BadgePiratesLLC/BadgePirates_Common_Library/Displays/README.md

BP Logo
# BadgePirates Common Library #

This repo contains our footprint library, logos, symbols and more

## How to import footprints into KiCad
[from SnapEDA](https://support.snapeda.com/en/articles/2651507-how-to-import-into-kicad)
1. In KiCad, go to Tools > Edit PCB Footprints.
2. Click on Preferences > Manage Footprint Libraries.
3. Click on Browse Libraries and navigate to the Folder of downloaded .kicad_mod file. Then click OK. The library will appear in the Global Libraries tab.

KiCad Browse

BadgePiratesLogos.pretty are also imported as footprints
