BadgePiratesLLC/BadgePirates_Common_Library/(threads)

Thread 5 (2022-10-19):

Create USB Type-C footprint in BadgePiratesLLC/BadgePirates_Common_Library

Reid-n0rc, 2022-10-19:
Created USB type-c footprint identified in BadgePiratesLLC/project-llama/issues/9

Closed 2022-10-26.
