BadgePiratesLLC/BadgePirates_Common_Library/(commit log)

2020-06-27 Create BatteryHolder_LINX_BAT-HLD-012-SMT.kicad_mod
    Added Battery Holder that we have in stock in the thousands! :)
2020-09-25 moved folders
    Moved Footprint folder and added symbol folder, moved footprints to footprint folder
2020-10-09 Update of Footprints
    Added Resister, Cap, button and switch footprints
2021-03-26 added files
    LED and PIN
2021-03-26 added FootPrints
2021-03-28 Updated for kicad 5.99, Added footprints for BSidesKC2021
2021-04-01 Create NG_Logo.kicad_mod
    adding Network Geek Logo FootPrint
2021-05-23 Holes and SAO Holder Back
2021-05-29 adding new footprints
2021-06-18 Create Slot_12mm.kicad_mod
    added a slot hole for Flat Head Lanyard clamp
2021-08-28 adding graphics to footprints
2021-09-27 Update Logo and adding footprints
2021-10-01 esp footprints
2021-12-30 Cleanup
    Cleaning some old footprints and adding new ones
2022-03-12 Footprints add
    adding some footprints
2022-04-27 Update LED_Osram_Lx_P47F_D2mm_ReverseMount_Proper_Mask Only.kicad_mod
2022-06-24 Fixing Battery and LED Logo
2022-09-05 adding footprints
2022-09-13 Update 2032 Through Hold Holder.kicad_mod
2022-09-13 Moving Footprints
    moving project specific footprint to their specific projects
2022-09-25 update footprints
2022-10-01 adding footprints
    MouseBites and 2450 Footprint
2022-10-03 Add PESD2USB3UV-TR
    Added PESD2USB3UV-TR ESD protection diode to the library.
2022-10-03 Update README.md
    Changed "Logos.pretty" on the last line to match the actual footprint library name.
2022-10-14 Create LED_RGB_1210.kicad_mod
    created a 4 pin RGB Reverse Mount Footprint
2022-10-16 Added symbol for IFX27001TFV
    Added modified symbol of IFX27001TFV that includes 4th pin for output to match the actual part and be usable on default KiCad footprint.
2022-10-16 Added additional symbol for IFX27001TFV33 fixed regulator
    Added additional symbol for IFX27001TFV33 fixed regulator with 4th pin to allow for default footprint to be used.
2022-10-26 Create GT-USB-7002C.kicad_mod
    Created footprint for GT-USB-7002C
2022-10-26 Created symbol for USB C Connector
    Created symbol for USB C Connector and linked to BP footprint TYPE-C-31-M-14
2022-11-19 Create a footprint for when Pin 2 and 4 of TO-223 are combined
    Create a footprint for when Pin 2 and 4 of TO-223 have a combined function, such as output.
2022-11-21 Create 2032 Through Hold Holder.kicad_mod
2022-11-23 Footprint Adjustments
2022-12-07 Added Sparkfun KiCad library as a submodule
2023-01-13 Create TPS61040 Symbol
    Create symbol for TPS61040 switching regulator.
2023-01-18 Created TPS63020 and +3V7 Power pin
2023-01-21 Created +2V3 power symbol
2023-01-21 Fixed TPS61023 symbol to match schematic
2023-02-07 Create CD54_IND.kicad_mod
    Created footprint for the XRCD54-1R0M_ inductor
2023-02-07 Stole footprints from Wrickert
2023-05-14 updating Footprints
2023-06-15 new Footprint and Symbol for SP4T
2023-07-10 Fix footprint
    Change footprint to SOT563
2023-07-12 AMAMW footprint
2023-07-13 Better align solder mask.
2023-07-18 Created M24SR02-Y
    Created M24SR02-Y IC RFID Transponder with I2C 8SO
2023-07-18 Updated M23SR02 default footprint
2023-07-18 Removed solder mask from vias
2023-07-18 Update 5.5uH_coil.kicad_mod
    Update 5.5uH_coil to have 6mil lines/spaces
2023-07-25 Created TPS63000DRC
    Created TPS63000DRC buck-boost converter designed to be used with LiPo batteries
2023-07-25 Added TPS61170 Buck,Boost,SEPIC regulator
2023-07-25 Create a net tie symbol and footprint
    Create net tie symbol and footprint for tying different nets, like split grounds, together at a single point.
2023-07-26 Added part info to SAO connector
    Added part numbers, Vendor names and vendor pn, default footprints to the SAO connector symbol
2023-07-26 Update Fab Attr
    Updated fabrication attributes to aid with DRC and BOM generation.
2023-07-31 Added Keebio-parts library
    Added Keebio-parts library as a submodule for the SK6812MINI-e footprint
2023-08-03 Update LED_Osram_Lx_P47F_D2mm_ReverseMount_Proper_Mask Only.kicad_mod
    Added solder mask removal on the Front layer. Defined keep one zone that will include removing copper pours on Front, Back, and Inner layers.
2023-08-03 Update LED_RGB_1210.kicad_mod
    Changed the keep out rule to apply to all layers including inner. Added mask to front.
2023-08-07 Modified rear LED footprints
    Removed the restrictions on the front mask and front keep out rules to allow for custom shapes on the front.
2023-08-22 adding common footprints
2023-08-22 update to Pad Headers .. and 14500 Battery footprings
2023-10-15 fixing some reverse mount settings and makermarks
2023-10-26 Added MAX17048 symbol and footprint
2023-10-30 making some footprints
2023-11-04 Update TF_PUSH.kicad_mod
    Some change didn't get save. Now it is
2023-11-04 Update TF_PUSH.kicad_mod
    Fixed pin numbers
2024-07-21 Update QBLP615.kicad_mod
    Fixed marking
2024-07-24 new footprints
2024-08-12 footprint update
2024-10-05 Create SW_SPST_TL3342 (NewButton).kicad_mod
2026-06-10 Add RFM95W (SX1276) symbol + HOPERF_RFM9XW_SMD footprint
    For the CC15 LoRa satellite. Symbol copied from KiCad 9 stock RF_Module
    lib; Footprint property set to BadgePirates:HOPERF_RFM9XW_SMD (footprint
    added to BadgePiratesFootprint.pretty). Validated with kicad-cli sym upgrade.
2026-06-10 Dedupe footprints: keep BadgePirates copies, drop redundant alternates
    Removed 6 duplicate footprints (kept the design-referenced BadgePirates:
    versions, which are equal-or-better — e.g. only BadgePirates SOT-223 had a
    3D model). Dropped: ESP32-S3-WROOM-1 / ESP32-S2-WROOM / ESP32-S2-WROVER from
    Espressif.pretty; SOT-223 / SOIC-8-1EP_W3.9mm / SOD-123 from
    digikey-footprints.pretty. Submodules (kicad-libraries, SparkFun, Keebio)
    untouched. Reversible via git if any old badge referenced those nicknames.
2026-06-10 Backfill MFG_PN on parts with known part numbers
    Filled MFG/MFG_PN (+LCSC where in Master BOM) for: C_100uf_CASE-B-3528
    (TAJB107M006RNJ / C7195), NE555DR, 74HC4017D-Q100J, 74HC75D,653.
    Validated with kicad-cli sym upgrade. Other blank-MFG_PN parts are either
    not in the Master BOM, part FAMILIES needing an orderable suffix, or
    generics (jumpers/net-ties/SAO connector) with no MPN — left blank rather
    than guess a wrong sourcing number.
2026-06-10 Add stock KiCad 3D models to 5 standard-package footprints
    SOD-123, CAPC3216X135 (1206 cap), RESC3216X70 (1206 res), SOT-223_2-4,
    SOT95P280X145-5N (SOT-23-5) now reference KiCad's stock .step models
    (${KICAD9_3DMODEL_DIR}), with the aligned offset/rotate copied from the
    matching stock footprint. Verify alignment in 3D view. Custom parts
    (buzzer, screen, USB-C, encoder, SD, OLED, etc.) still need sourced STEP files.
2026-06-10 TL3341 + PushPush switch footprints
2026-06-11 Add Johanson 0915AT43A0026 915MHz chip antenna footprint (for CC15 LoRa)
2026-08-22 repo: stop KiCad local state and CRLF churn from dirtying the tree (Nexus edd15f3d)
    Same fix applied to cc15 (cbce6f8). Windows git EOL-converts KiCad files on
    checkout, so they show modified with an empty content diff; combined with
    tracked .kicad_prl / fp-info-cache and a '*-backup/' vs '*-backups/' gitignore
    near-miss, every KiCad open dirtied the tree. The GamingCrap auto-pull task is
    fast-forward-only and refuses on a dirty tree, so the repo silently stopped
    updating. Kevin should type nothing to open a project.
2026-08-23 feat(lora-satellite-v2): add Seeed Wio-SX1262 footprint + symbol (Nexus e2770234)
    Footprint geometry pulled from Seeed's own production KiCad project
    (github.com/Seeed-Studio/OPL_Kicad_Library, Wio-SX1262 for XIAO ESP32S3,
    Module:MODULE12P-1.27-11X11.6MM), re-centered on origin. Matches datasheet
    Figure 9 (Wio-SX1262 Module Datasheet V1.0). 12-pin symbol wired to real
    pinout: RF_SW/MISO/MOSI/SCK/NRST/NSS/GND/VCC on left, ANT/GND/BUSY/DIO1 on
    right, per Figure 2. RF_SW confirmed safe to leave unconnected — Meshtastic's
    shipped variant for this exact module (seeed_xiao_s3/variant.h) uses
    SX126X_DIO2_AS_RF_SWITCH and never drives RF_SW.
2026-08-23 fix(hardware,bucky): Seeed_Wio-SX1262 footprint pad size was transposed, causing adjacent-pad copper overlap
    Pad size was (1.6mm along pitch axis, 0.6mm across) for all 12 gull-wing
    pads at 1.27mm pitch. 1.6mm width at 1.27mm pitch overlaps adjacent pads
    by ~0.33mm of copper -- a dead short between every adjacent signal
    (SCK-NRST, NRST-NSS, NSS-GND, GND-VCC, etc). Confirmed via pcbnew
    GetBoundingBox() on adjacent pads, then reproduced as kicad-cli DRC
    solder_mask_bridge violations on the LoRa v2 satellite layout (Nexus
    e2770234) before this was caught.
    Swapped to (0.6mm across pitch, 1.6mm extending away from the body) --
    standard gull-wing pad proportions for this pitch, matches typical SM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
2026-08-30 feat(bucky): add C_1206_3216Metric footprint, missing 1206 capacitor size
    Library had R_1206_3216Metric and LED_1206 but no capacitor equivalent —
    needed to resize hand-solder-standard passives (Nexus 81b1b9cb) on any
    board using sub-1206 caps. Same pad/courtyard geometry as the existing
    1206 parts in this library for consistency.
    Nexus ab5c2979.
2026-08-30 Add silkscreen pin-1 dot to 25 orientation-sensitive footprints missing one
    Audit for Nexus 32486e5c (Kevin: SAO-NFC v1.0 shipped U1 with no pin-1
    indicator at all, cost an afternoon establishing orientation before the real
    bug could be looked at). ICs, diodes, LEDs, electrolytics, connectors, and
    battery holders across BadgePiratesFootprint.pretty had no silkscreen dot and
    in some cases no courtyard at all. Placed a filled F.SilkS circle at the
    courtyard/body corner nearest pin 1/anode-cathode pad, verified every edited
    footprint still parses and exports via kicad-cli.
    Courtyard notch/chamfer (the second, redundant indicator the standard also
    calls for) is not done here — needs correct-b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
2026-08-30 Un-track VZ43FC1B5640007L-ERM-Motor.kicad_mod — not part of this change
    Swept in by a glob add alongside the pin-1 dot commit; it's someone else's
    in-progress footprint (untracked before my commit). Leaving the file on disk,
    just removing it from git so it doesn't ship under my commit message.
2026-08-30 feat(hardware,bucky): author ESP32-S3-MINI-1 KiCad symbol (Nexus e2770234)
    No native Espressif KiCad symbol exists for the MINI-1 module, and the
    library's existing "ESP32-S3" symbol is the bare QFN-56 chip with the
    wrong pin count/numbering for the module. Authored a new symbol with
    46 unique pin numbers (1-45 signal + shared GND ring pad 46), matching
    the existing Espressif.pretty/ESP32-S3-MINI-1.kicad_mod footprint's 46
    unique pad numbers pad-for-pad.
    Pin names/functions sourced from Espressif's official Table 3-1 Pin
    Definitions (esp32-s3-mini-1_mini-1u_datasheet_en, documentation.espressif.com),
    cross-checked against the Mouser-hosted copy of the same datasheet.
    Key pins for the LoRa-S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
2026-08-31 fix(footprint): add silkscreen pin-1 dot to PinHeader_1x02_P2.54mm_Vertical
    Missed by the 3955a13 audit (Nexus 32486e5c). Filled F.SilkS circle at the
    courtyard corner nearest pad 1, verified via kicad-cli fp export svg (renders
    clean, no pad overlap). Part of closing hw-deliverables pin1-marker-check
    findings (Nexus b8df6668).
2026-09-01 fix(m24sr02): fill blank MPN/Vendor1_PN for M24SR02-Y
    Nexus 0366842c QA flagged M24SR02-Y had a blank MPN despite being on
    the known-blank list. Filled from the exact part handed to dev in the
    ticket: M24SR02-YMN6T/2, DigiKey 497-14353-1-ND. Validated with
    kicad-cli sym upgrade before commit per library's fragile
    textual-property-edit history.
2026-09-01 Add courtyard chamfer notch at pin-1 corner (Nexus b639d863 / 32486e5c)
    Second half of the pin-1 marker standard: 3955a13 added the silkscreen dot
    but deferred the courtyard notch as "needs correct-by-construction polygon
    editing per footprint." Scripted it instead of doing it by hand in the
    KiCad GUI (Jared, fleet review on b639d863, confirmed this is scriptable
    file-editing, not GUI-only work).
    For each footprint from 3955a13 (minus VZ43FC1B5640007L-ERM-Motor, which
    e805fe5 already untracked as out of scope): parsed the F.CrtYd rectangle,
    found the pin-1 dot's nearest corner, and replaced that corner's two
    fp_line segments with a chamfer of min(0.5mm, 25% of the shorter courtyard
    side)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
2026-09-21 fix(3d): repoint 29 stale 3D model paths to KICAD10_3DMODEL_DIR
    Footprints referenced KICAD6/7/8/9_3DMODEL_DIR or KISYS3DMOD, none of
    which resolve on a KiCad 10 install (GAMINGCRAP), plus stale .wrl
    extensions where the upstream model shipped as .step. Filesystem-
    verified each new path resolves against the actual KiCad 10.0.6
    bundled 3dmodels folder before rewriting.
    Nexus 265f2f6a.
2026-09-27 fix(3d-model): point ESP32-S3-WROOM-1 and LED_Osram ReverseMount at portable ${BADGEPIRATES_COMMON_LIB} path
    Both had absolute C:/Users/KevinBennett/OneDrive... paths baked in from the
    original import; the referenced .STEP/.step files are actually present in
    this repo, they were just unresolvable off Kevin's machine. Nexus bb16f69c.
2026-09-27 fix(3d-models): bulk-assign KiCad stock 3D models to generic chip footprints
    0603/0805/1206/1210 in digikey-footprints.pretty were bare 2-pad SMD
    footprints with no model block at all. These are standard imperial chip
    sizes with a 1:1 shape match in KiCad's own shipped library, so point
    them at ${KICAD10_3DMODEL_DIR}/Resistor_SMD.3dshapes/*.step instead of
    sourcing individual STEP files -- cosmetic body shape only, no vendor
    part implied.
    Part of Nexus bb16f69c item 2b (digikey-footprints.pretty bulk pass).
2026-09-27 fix(3d-model): repoint LED_Osram ReverseMount_Proper_Mask sibling to portable path
    Carla's QA on bb16f69c caught this one: same OneDrive absolute-path
    bug as its sibling LED_Osram_..._ReverseMount_WHole (fixed in 0dab6ef)
    but missed in that pass. ReverseMount.step already exists in-repo.
2026-09-27 fix(footprint): close malformed F.CrtYd courtyard on BatteryHolder_MPD_BC2003_1x2032
    Both courtyard arc endpoints were off by ~0.01-0.03mm from the
    adjacent line endpoints, leaving the polygon open and tripping
    KiCad 10's malformed_courtyard DRC on every board using this
    holder (all 4 Celebration 2022 variants). Snapped both arc
    start/end coords to exactly match the neighboring line endpoints
    (-8.94,-5.01 / 8.94,-5.01 / -8.94,5.01 / 8.94,5.01) and centered
    the mid points at (0, +/-10.248).
    Left the _Fixed sibling footprint alone -- it is a different
    variant (different silk text, ref orientation, sheet source),
    not a drop-in replacement, so boards were not swapped to it.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
2026-09-27 fix(3d-models): bulk-assign KiCad stock 3D models to 10 digikey generic packages
    Matched digikey-footprints.pretty entries to identically-dimensioned
    stock KiCad footprints (LGA-24/28, SOD-523, SOIC-18W/24W, SOT-323/353/
    363/563, TO-269AA) by pin count + pad count + package dimension, then
    copied the stock model reference. Verified each resolves against the
    actual KiCad 10 3dmodels dir with ops/kicad_3d_model_check.py's own
    resolver, not by inspection alone.
    Tried SOT-523 too (same pin/pad-count match against KiCad's own stock
    SOT-523.kicad_mod) but KiCad's bundled 3dmodels tree is missing that
    step file too -- reverted, left with no model block rather than a
    second broken reference.
    Nexus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
2026-09-27 fix(3d-models): bulk-assign KiCad stock 3D models to 5 more digikey SOT/SC-70 packages
    Matched digikey-footprints.pretty SOT-23-3/6/8, SOT-23W, and SC-70-5 to
    identically-named stock KiCad footprints by pad count + pad position
    (not name alone -- diffed pad coordinates against the stock
    Package_TO_SOT_SMD.pretty footprints first). Verified each resolves
    using the actual gate script's own resolve_path(), not os.path.exists
    by hand.
    Nexus bb16f69c.
2026-09-27 fix(3d-models): quote+repoint 46 legacy unquoted model paths to resolving KiCad10 stock STEPs
    The gate script's resolve_path() regex requires a quoted (model "...")
    path -- these 46 footprints (mostly Displays/*, plus a handful of
    digikey/BadgePiratesFootprint/Espressif entries) used the pre-KiCad-6
    unquoted legacy syntax (model ${KISYS3DMOD}/... or ${ESPRESSIF_3DMODELS}/...
    with no quotes), so the gate silently miscounted them as "no model" even
    though KiCad itself resolves the bare-token form fine locally when those
    vars happen to be set.
    Repointed each to the equivalent file under KiCad 10's own bundled
    3dmodels tree (same basename, several needed a .wrl->.step swap or a
    different sub-li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
2026-09-28 fix(3d-model): drop unresolvable BATHLD006SMT model block
    The (model ...) block pointed at a literal Windows OneDrive absolute path
    (C:\Users\CrapDesktop\OneDrive - Tier 3 Tech\...\BAT-HLD-006-SMT.stp) that
    never resolves off that one machine, and the referenced .stp isn't in this
    repo at all -- unlike TBU1's tbu-ca.stp, there's nothing to repoint at.
    Dropping the block turns this from a misleading "unresolved" into an
    honest "no model", tracked for real sourcing in the large-effort bucket
    (hardware/audits/3d-audit-unresolved.txt). Nexus bb16f69c Item 1.
2026-09-30 fix(3d-models): add missing model block to SOIC-8-1EP_W3.9mm (CC15)
    Only footprint on the 5 live boards (CC15/LoRa v1/v2/SAO-NFC/BSidesKC27)
    still lacking a model block after prior 9/26-27 bulk fixes. Assigned
    KiCad stock Package_SO.3dshapes/SOIC-8-1EP_3.9x4.9mm_P1.27mm_EP2.41x3.81mm.step,
    verified file exists on host.
    Ref Nexus 5f7525b7.
2026-09-30 fix(3d-models): assign KiCad-stock STEP models to 11 exact-match digikey footprints
    Part of Nexus 5f7525b7 digikey-footprints.pretty bulk-assignment pass.
    Filename-exact matches only (DIP-N_W*mm, SOT-553, TO-18-3, TO-39-3)
    verified against pad count and physical STEP file presence before assignment.
2026-10-01 fix(3d-models): assign KiCad-stock STEP model to SOIC-8_W3.9mm (8-pad exact match)
2026-10-01 fix(3d-models): assign KiCad-stock STEP models to SOD-323/SOD-323F digikey footprints
    Both verified: pad count (2) and dimensions match Diode_SMD.pretty
    D_SOD-323/D_SOD-323F, and both STEP files confirmed present on disk
    (KiCad.app/Contents/SharedSupport/3dmodels/Diode_SMD.3dshapes/).
    SOT-523 was considered but skipped — the stock footprint references
    a STEP file that does not actually exist in the installed library,
    so assigning it would repeat the dangling-model-path bug already
    flagged elsewhere on this ticket.
    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
2026-10-01 fix(3d-models): assign KiCad-stock STEP models to DO-214AC and TO-92-3
    DO-214AC pads (at +-2,0, size 2.5x1.7) match Diode_SMD.pretty D_SMA
    (at +-2,0, size 2.5x1.8) - exact position, industry-standard DO-214AC=SMA.
    TO-92-3 pad positions (0, 1.27, 2.54 in a line, rect+oval+oval) match
    Package_TO_SOT_THT.pretty TO-92_Inline exactly - this is the inline
    variant, not the staggered TO-92.kicad_mod (which has a different
    pad-2 Y offset and would be the wrong body shape).
    DO-214AB and DO-35/DO-41 were checked and skipped: DO-214AB pad spacing
    (+-3.45mm) doesn't match any stock SMB/SMC pitch, and DO-35/DO-41 pad
    pitch (8.56mm/9.2m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
2026-10-01 fix(3d-models): assign stock Package_SO.pretty models to 5 digikey-footprints.pretty SOIC/TSSOP parts
    Verified pad pitch (and pad position in 3 of 5 cases, exact to 4 decimals)
    against stock KiCad footprints before assigning:
    - SOIC-8_W5.3mm -> SOIC-8_5.3x6.2mm_P1.27mm.step (1.27mm pitch match, 5.3mm body matches name)
    - SOIC-16_W3.90mm -> SOIC-16_3.9x9.9mm_P1.27mm.step (pad position exact match, 3.9mm body matches name)
    - TSSOP-8_W4.4mm -> TSSOP-8_4.4x3mm_P0.65mm.step (pad position exact match)
    - TSSOP-20_W4.4mm -> TSSOP-20_4.4x6.5mm_P0.65mm.step (pad position exact match)
    - TSSOP-16-1EP_W4.40mm -> TSSOP-16-1EP_4.4x5mm_P0.65mm.step (0.65mm pitch match, EP package)
    All 5 STEP files confirme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
2026-10-01 feat(3dmodels): assign stock Package_QFP STEP models to 6 digikey TQFP/LQFP footprints
    TQFP-32/48/64_7x7mm and LQFP-32/48_7x7mm, LQFP-64_10x10mm matched to
    stock KiCad Package_QFP.pretty by pin pitch and body size; pad Y-pitch
    exact match, X-extent within rounding of pad-length convention.
    Part of Nexus 5f7525b7-d9de-4e6b-957f-6200b8931c82.
2026-10-01 3D models: assign 6 more digikey-footprints.pretty packages to stock STEP files
    TSSOP-14_W4.4mm -> TSSOP-14_4.4x5mm_P0.65mm.step
    TSSOP-24_W4.40mm -> TSSOP-24_4.4x7.8mm_P0.65mm.step
    TSSOP-28_W4.40mm -> TSSOP-28_4.4x9.7mm_P0.65mm.step
    SOIC-20_W7.5mm -> SOIC-20W_7.5x12.8mm_P1.27mm.step
    SOIC-28_W7.5mm -> SOIC-28W_7.5x17.9mm_P1.27mm.step
    TSSOP-8_W3mm -> TSSOP-8_3x3mm_P0.65mm.step
    Matched by exact pin pitch and pin count, with row separation within
    0.03-0.12mm of the digikey value (consistent with earlier TQFP/LQFP
    findings that digikey pad-length convention differs slightly from
    KiCad's IPC-derived stock footprints). All 6 STEP files confirmed
    present on disk under Package_SO.3dshapes before com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
2026-10-01 3d-models: assign DIP-14_W3mm -> DIP-14_W7.62mm.step
    Row separation (7.62mm) and 14-pin thru-hole pattern match stock
    Package_DIP DIP-14_W7.62mm exactly; digikey's W3mm name refers to a
    different dimension than row spacing. STEP confirmed present on disk.
2026-10-01 fix(3d-models): assign 3 more digikey-footprints.pretty 3D models
    HTQFP-100_14x14mm -> TQFP-100_14x14mm_P0.5mm.step (100 pads, no EP, exact body/pitch match)
    LQFP-100_14x14mm -> LQFP-100_14x14mm_P0.5mm.step (100 pads, no EP, exact body/pitch match)
    LED_0603 -> LED_0603_1608Metric.step (0603/1608 metric LED chip body match)
    Part of Nexus 5f7525b7 3D model library sourcing.
2026-10-01 fix(3d-models): repair 2 broken BadgePiratesFootprint.pretty model paths
    Keystone-1042-0: eec.models/Keystone_-_1042.step (doesn't exist anywhere)
    -> stock Battery.3dshapes/BatteryHolder_Keystone_1042_1x18650.step,
    confirmed by exact Keystone part number match + descr "18650 Plastic
    Battery Holder, Surface Mount".
    SW_Slide_1P2T_CK_TH: stale .wrl path to
    SW_Slide_1P2T_CK_OS102011MS2Q.wrl (KiCad 10 dropped wrl) -> stock
    Button_Switch_THT.3dshapes/SW_Slide_SPDT_Straight_CK_OS102011MS2Q.step,
    confirmed by exact CK Components part number match (OS102011MS2Q is
    the straight variant, not the Angled MA1Q).
2026-10-01 fix(3d-models): assign stock PinHeader 3D models to 7 digikey-footprints.pretty headers
    Pad geometry (straight single/dual row, P2.54mm) matches KiCad stock
    Connector_PinHeader_2.54mm.3dshapes exactly for pin count and orientation;
    minor drill-diameter differences (e.g. 1.02mm vs stock) don't affect the
    3D model since it's render-only, not fab data.
    Nexus 5f7525b7-d9de-4e6b-957f-6200b8931c82
2026-10-01 fix(3d-models): assign stock PinHeader models for 5 more digikey-footprints.pretty headers
    Straight THT single/dual-row headers at P2.54/P2.00/P1.27mm pitch match
    stock Connector_PinHeader_*.3dshapes exactly on pin count and orientation.
    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
2026-10-01 fix(3d-models): assign stock SSOP models for SSOP-16_W3.90mm, SSOP-20_W3.9mm
    Pad pitch (0.635mm) and pin count verified against stock Package_SO.3dshapes
    SSOP-16_3.9x4.9mm_P0.635mm.step and SSOP-20_3.9x8.7mm_P0.635mm.step.
    Nexus 5f7525b7
2026-10-01 3d-model: assign Keystone-54 battery clip STEP
    Verified by pad pattern (3x thru-hole circles at 0,-2.9 / ±5.08,4.72,
    2.78mm pad / 1.83mm drill, courtyard ~19.6x13mm) matching Keystone 54
    spring-clip battery holder for 16-19mm cylindrical cells.
    Nexus 5f7525b7.
2026-10-02 fix(3d-models): assign stock DIP socket models to 12 digikey-footprints.pretty sockets
    Verified pad geometry (pin count, 1.524mm pad / 0.762mm drill, 2.54mm pitch,
    7.62mm or 15.24mm row width) matches stock Package_DIP.pretty *_Socket STEPs
    exactly for each variant.
2026-10-02 fix(3d-models): assign stock D_SMC model to DO-214AB (SMC package)
    Verified pad geometry: A/K smd rect at +-3.45mm, 2.5x3.3mm matches
    stock Diode_SMD D_SMC.step (pad at -3.4mm, 3.3x2.5mm rotated 90).
    DO-214AB is the formal package name for the SMC diode footprint.
    Checked DO-35/DO-35_NK (8.56mm pitch) and DO-41 (9.2mm pitch) against
    stock Diode_THT models -- neither pitch matches any stock variant
    (12.70/2.54mm and 10.16/5.08mm respectively), skipped rather than guess.
    Confirmed DFN-10_2x2mm_P0.4mm / DFN-10_3x3mm / DFN-12-1EP_3x3mm /
    DFN-6_3x3mm_EP1 remain a known blocker: stock Package_DFN_QFN.pretty
    kicad_mod exists but has no corresponding 3dshapes STEP on disk either.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
2026-10-02 3d-models: assign stock TO-220-3/TO-247-3 STEP models
    Verified pad geometry exact match against Package_TO_SOT_THT.pretty
    stock footprints (pad positions 0/2.54/5.08mm and 0/5.45/10.9mm
    respectively). Confirmed target STEP files exist on disk.
2026-10-02 3D models: assign Coax_Conn_U.FL and QFN-48-1EP_7x7mm (digikey-footprints.pretty)
    Coax_Conn_U.FL -> stock Connector_Coaxial/U.FL_Hirose_U.FL-R-SMT-1_Vertical.step,
    rotate z=-90 to align: digikey's ground pads sit at (+/-1.475,0) vs stock's
    (0,+/-1.475), and digikey's signal pad at (0,1.5) vs stock's (-1.525,0) --
    consistent with a 90-degree footprint rotation, confirmed on both pad pairs.
    QFN-48-1EP_7x7mm -> stock Package_DFN_QFN/QFN-48-1EP_7x7mm_P0.5mm_EP5.15x5.15mm.step,
    rotate 0: pin-1 pad position (-3.475,-2.75) and EP size (5.15x5.15) match stock
    exactly, no rotation needed.
    Checked and skipped (EP/pitch matched but rotation unverifiable from pad data
    alone, no stock match at all, or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
2026-10-02 3d-models: assign stock QFP/SOT-23-6 steps (TQFP-44/100x2, SOT23-6L)
    Verified by exact pad-pitch/position match against stock Package_QFP.pretty
    and Package_TO_SOT_SMD.pretty footprints (TQFP-44_10x10mm_P0.8mm,
    TQFP-100_14x14mm_P0.5mm direct; TQFP-100_12x12mm_P0.4mm and SOT23-6L rotated
    -90deg, confirmed by pad-position rotation algebra). Nexus 5f7525b7.
2026-10-02 3d-models: assign stock SSOP-20/28 5.3mm STEPs (rotate 90, verified by pad-rotation algebra)
2026-10-02 3d-models: assign stock PinHeader_1x03_P2.54mm_Vertical step (digikey-footprints.pretty)
    Verified exact pad match (3x thru_hole circle, 2.02mm pad, 1.02mm drill,
    2.54mm pitch) against the stock KiCad PinHeader_1x03_P2.54mm_Vertical
    footprint -- same geometry already confirmed correct for the sibling
    PinHeader_1x2_P2.54mm_Drill1.02mm fix in an earlier session.
2026-10-03 3d-models: assign stock TO-220-11 StaggerOdd STEP (offset verified by kicad-cli render)
    Pad geometry is an exact translated match to Package_TO_SOT_THT.pretty's
    TO-220-11_P3.4x5.08mm_StaggerOdd_Lead4.58mm_Vertical (pitch 1.7mm, stagger
    5.08mm, identical relative-to-pin1 pattern). Digikey's footprint origin is
    centered on the mid pin rather than pin1, so offset (-8.5, 5.08, 0) was
    needed instead of the usual (0,0,0). Verified empirically with
    kicad-cli pcb render (top-orthographic, pixel-measured pad vs lead-tip
    alignment) rather than trusting the algebra alone -- an oblique isometric
    render of the same offset looked misaligned due to perspective, so the
    top-down check was the deciding eviden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
2026-10-03 BadgePiratesFootprint.pretty: assign STEP to CR2032/2032 TH Holder
    LCSC C5239862 (BS-02-A1AJ010, THT 2-pin coin holder) matches both
    duplicate footprints' pad geometry within manufacturing tolerance:
    pitch 20.00mm vs our 19.96mm, drill 1.2mm vs 1.25mm, pad OD 1.8mm vs
    1.7524mm (all deltas <=0.05mm). Pulled via easyeda2kicad, verified
    by kicad-cli pcb render that the model sits correctly over the pads
    before assigning. Rotated 90deg since the source part's pitch runs
    along X and ours runs along Y.
    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
2026-10-03 footprint(TYPE-C-31-M-14): assign STEP model from LCSC C223907 (exact Hroparts part match)
    Pulled via easyeda2kicad, pad geometry/outline matches footprint's own
    descr (Hroparts TYPE-C-31-M-14). Verified by kicad-cli pcb render:
    model loads (0.84s vs ~0.02s empty) and seats correctly over the SMD
    pad row with default offset/rotation, no adjustment needed.
2026-10-03 feat(3d-models): assign STEP for FUET-9032-Buzzer (LCSC C417433)
    Exact part-name match (FUET-9032-3.6V). Pad pitch 8mm matches our
    footprint's 0/8mm pad spacing exactly; body diameter 9.0mm vs our
    silkscreen's 8mm is within cosmetic tolerance for a non-fab-blocking
    model. Verified with kicad-cli pcb render test board before assigning
    (0.39s model-load time, body centered over both pads, + polarity mark
    visible).
    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
2026-10-03 3D models: assign LED_0807, TF_PUSH, CN330N (Nexus 5f7525b7)
    - LED_0807: stock LED_0805_2012Metric.step (pad geom within 0.17mm, cosmetic-only)
    - TF_PUSH: LCSC C393941 SHOU HAN TF-PUSH via easyeda2kicad, exact pad/name match,
    render-verified with offset (0,-6.1,0) correcting origin shift
    - CN330N: stock SOIC-8_3.9x4.9mm_P1.27mm.step rotated 90z (descr says SOIC8,
    pads match pitch/size within tolerance), referenced via KICAD10_3DMODEL_DIR
    (no local copy needed, matches stock-footprint convention)
    All verified via kicad-cli pcb render test boards before assigning.
2026-10-03 feat(3d-models): assign CD54_IND STEP from Sumida CD54 series (LCSC C2826664)
    Pad geometry near-exact match (2.54x5.5mm size, 3.94mm pitch vs reference
    2.5x5.5mm/4.0mm pitch -- 0.06mm delta). Render-verified: drum body
    centered over pads, lead terminations land at pad edges.
    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
2026-10-04 remove stray Footprint Editor.kicad_mod scratch artifact
    Not a real part: reference REF**, value literally 'Footprint Editor',
    no manufacturer geometry. Not referenced by any board pcb/sch in
    agent-repo or this library. Confirmed via git-log/grep evidence per
    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
2026-10-04 feat(3d-models): assign stock PinHeader_2x03_P2.54mm_Vertical STEP to SAOv169 2x3 box headers
    Both footprints' descr explicitly name a through-hole 2x03 2.54mm box
    header. Pad layout is the stock KiCad PinHeader_2x03_P2.54mm_Vertical
    footprint rotated 90deg (3 cols x 2 rows vs stock's 2 cols x 3 rows).
    Render-verified with kicad-cli pcb render before assigning offset.
    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
2026-10-04 feat(3d-models): assign STEP to SSD1306-0.91-OLED-4pin-128x32
    LCSC C5248081 (HS HS91L02W2C01) generated footprint name
    (OLED-TH_L38.0-W12.0) matches our 38x12mm board outline exactly,
    pad pitch 2.54mm/drill 1mm match exactly. Pulled via easyeda2kicad,
    render-verified with kicad-cli pcb render -- pads land centered on
    the connector holes, pin-1 marker visible, board outline matches.
    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
2026-10-04 feat(3d-models): assign GT-USB-7002C STEP (LCSC C5117884, exact name match)
    Nexus 5f7525b7. Pulled via easyeda2kicad (USB-C-SMD_GT-USB-7002C footprint
    name matches our GT-USB-7002C exactly). Pad pitch/drill/shell-tab spread
    confirmed matching ours within tolerance. Offset (0 -2.4 0), no rotation.
    Render-verified by temporarily inserting into a scratch copy of
    Project-Sparky.kicad_pcb (not committed) and rendering with kicad-cli --
    connector body lands centered over all 6 signal pads and 4 shell tabs.
2026-10-04 feat(3d-models): assign C2858290 STEP (exact LCSC part-number match)
    Footprint name is literally the LCSC ID. easyeda2kicad pull of C2858290
    produces SW-SMD-6P-L10.5-W10.0, a 6-pad SMD D-pad switch with 2 mounting
    holes at (+-2.2, 2.2) — exact pad coordinate match to our footprint
    (within 0.05mm on all 6 SMD pads, exact on both mounting holes). No
    offset/rotation needed; coordinate systems align directly. Render-verified
    with kicad-cli pcb render before committing.
2026-10-04 feat(3d-models): assign RESDFN650X400X90-2N STEP (Bourns TBU-CA085-200-WH, LCSC C720643)
    Identified real part via Project-Sparky schematic: this footprint backs
    TBU1, lib_id uctester-eagle-import:TBU-CA, value "TBU-CA". Bourns TBU-CA
    high-speed protectors ship in a DFN2 6.5x4.0x0.9mm SMD-3P package matching
    the footprint descr exactly. easyeda2kicad pull of C720643 produces
    SEMI-SMD_TBU-CA085-200-WH with pads at (-2.02/0/2.02, 0), sizes 2.0x3.6 /
    1.0x3.6 / 2.0x3.6 -- matches our footprint's (-2.025/0/2.025, 0),
    1.9618x3.5118 / 0.8x3.5118 / 1.9618x3.5118 within 0.1mm. No offset/rotation
    needed. Render-verified against Project-Sparky before committing.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
2026-10-04 feat(3d-models): assign STEP to BATHLD006SMT - CR2450 (LCSC C6131016, BAT-HLD-006-SMT exact part match)
    Pad geometry match: two 6x6.2mm rect pads at ±15.3mm + 23mm circle center
    pad, matches generated footprint within 0.2mm. Render-verified against
    Project-Sparky scratch board — holder body with + marking and spring tabs
    lands correctly over the pad footprint.
    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
2026-10-04 feat(3d-models): assign XKB7070-Z-92 STEP (LCSC C318862)
    Exact part-number match named in the footprint's own descr field.
    easyeda2kicad pad geometry (5.0mm col x 2.0mm row, 1.0mm drill) matches
    ours exactly once transposed 90deg. Render-verified against a scratch
    Project-Sparky board before committing.
    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
2026-10-04 feat(3d-models): assign SIQ-02FVS3 encoder STEP (LCSC C2925423)
    Exact Mitsumi part-number match to footprint name. easyeda2kicad pad
    geometry confirms same part (same x-span, same NPTH offset pattern);
    render-verified offset (0 2.65 0) against scratch Project-Sparky board
    -- mounting legs land on the silkscreen box edge correctly.
    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
2026-10-04 fix(gitignore): ignore stray KiCad *-drc.rpt (Nexus f81f825c)
    A manually-exported DRC report from the KiCad GUI sat outside
    _deliverables/ and wasn't gitignored, so it counted as dirty source
    for hw_deliverables_gen.mjs and forced a full regen + Cortex warn
    every 10 minutes.
2026-10-04 fix(espressif): source 9 missing STEP models for ESPRESSIF_3DMODELS gap
    Espressif.pretty footprints referenced ${ESPRESSIF_3DMODELS}/*.STEP but no
    asset ever existed for any of them on this host or in this repo (Nexus
    88670327, LoRa-Satellite-v2 U2 pre-fab gate failure). Downloaded the 9
    STEP files Espressif.pretty actually references from the vendor's own
    espressif/kicad-libraries repo (CC-BY-SA 4.0) into Espressif.3dshapes/,
    same sibling-dir convention as BadgePiratesFootprint.3dshapes.
2026-10-05 fix(library): correct broken Footprint refs, dead 3D paths, Reference hygiene
    Nexus 21b75408 Phase 1/3 audit. Non-renaming, additive fixes only, no board
    re-pointing required (verified none of the touched symbols' old Footprint
    values were referenced by any current board):
    - ESP32-S2-WROOM, ESP32-S3-WROOM-1-N4/N8: Footprint field pointed at
    "Espressif:" names that don't exist in Espressif.pretty; repointed to the
    real BadgePirates:ESP32-S2-WROOM / BadgePirates:ESP32-S3-WROOM-1 footprints
    that already exist and already have resolving 3D models.
    - Badgelife_sao_connector_v169bis, NetTie_2: Footprint used nickname
    "BadgePirateFootprints" which isn't in any board's fp-lib-table (typo fo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
2026-10-05 fix(ch340n): correct 90-degree 3D model rotation on SOIC-8-1EP_W3.9mm
    Kevin's 2026-10-05 CC15 review caught the CH340N body rendering with
    pin 1 at the top-right instead of over the silkscreen pin-1 dot
    (top-left). The footprint's pads run top/bottom (rotated 90 deg from
    the stock SOIC-8-1EP_3.9x4.9mm pad layout, which runs left/right), but
    the model rotate was left at 0 0 0. Set rotate to 0 0 270 so the
    library-supplied STEP (pads verified against stock footprint geometry)
    lands pin 1 on pin 1.
2026-10-05 feat(3d-models): add battery-holder STEP (14500 Keystone53) + screen module footprint/3D (ILI9341 2.8in)
    Battery - 14500: attach Battery_14500_Keystone53_clips.step so BT1/BT2 show
    the actual spring-clip holder instead of a bare cell. Supersedes the
    2026-10-04 BT1/BT2 3d-model-check exemption.
    Display-IL19341V-BP version (J3): add B.Fab/B.CrtYd module outline
    (90.5x55.25mm per the Augusta memo), 4 NPTH mounting holes, and
    Display_ILI9341_2p8in_CapTouch.step so the purchased screen module shows
    in 3D instead of just the bare header.
    Nexus 9ef3094d-d114-46f6-a339-1a968f5eeb39
2026-10-05 feat(testpoint): add TestPoint symbol + THT_1.02mm footprint (gap fill)
    Bodiless test point, no 3D model needed per Kevin's exempt rule. Fills
    item 4 in bp-core-parts-standard.md 'still open' list - no equivalent
    existed anywhere in the fleet before. Validated with kicad-cli sym
    upgrade + fp upgrade (both round-trip clean).
2026-10-05 fix(fields): consolidate MFG_PN/MFG/LCSC field-key synonyms on 13 symbols
    Renamed MPN/Manufacturer_Part_Number/"MFG PN" -> MFG_PN, Manufacturer_Name/
    MANUFACTURER -> MFG, Vendor PN 1/Vendor_PN -> Vendor1_PN, Vendor 1 -> Vendor1,
    Vendor1_UPN -> Vendor1_URL. Dropped Mouser/RS distributor-specific fields,
    PROD_ID placeholders, STANDARD/PARTREV/MAXIMUM_PACKAGE_HEIGHT blanks, and
    Package (redundant with Footprint) per runbooks/design/bp-core-parts-standard.md.
    No symbol/footprint renames, no lib_id changes -- field values unchanged,
    only keys normalized. Verified no duplicate keys remain per symbol and the
    file round-trips clean through kicad-cli sym upgrade.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
2026-10-05 feat(symbols): promote M24SR02-YMN6T NFC IC + Buzzer_FUET-9032 into common library
    M24SR02-YMN6T_SOIC-8 ported from SAO-NFC-M24SR's local schematic symbol,
    with Footprint repointed from the project's broken local SAO-NFC:SOIC-8
    reference to the stock KiCad Package_SO:SOIC-8_3.9x4.9mm_P1.27mm (has a
    3D model already). No LCSC C-number found attached to the source symbol,
    left Vendor1 fields blank rather than guess.
    Buzzer_FUET-9032 pairs the existing FUET-9032-Buzzer footprint (which had
    no symbol) with a minimal 2-pin passive symbol, pad numbers verified
    against the .kicad_mod.
    Both validated via kicad-cli sym upgrade round-trip before push.
2026-10-05 fix(symbols): bulk Vendor1_PN -> LCSC rename + finish field-key consolidation
    Completes the field-key hygiene pass that commit 4d458ca only partially
    applied:
    - 37 symbols: renamed Vendor1_PN -> LCSC (the value was already a real
    LCSC C-number for 36 of them; dropped the now-redundant Vendor1="LCSC"
    sibling on each). LTC4054's Vendor1_PN held "TP4054ST25K" (a MFG_PN, not
    a C-number) -- corrected to the real LCSC C-number C382138, verified
    against that same symbol's own Vendor1_URL and Datasheet fields which
    both already named C382138. MFG_PN left untouched.
    - 3 symbols kept Vendor1/Vendor1_PN as-is (Battery_Connector_14500_x2,
    LED_Yellow_ReverseMount_Gullwing, M24SR02-Y) -- thei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
2026-10-05 fix(symbols): drop comma from 74HC75D,653 lib_id per KLC naming convention
    Symbol/Value were "74HC75D,653" -- a bare comma in a KiCad symbol name
    violates the no-embedded-commas rule already applied to this library
    (bp-core-parts-standard.md). Renamed lib_id + unit names to
    74HC75D653. MFG_PN left untouched as "74HC75D,653" -- that comma is
    Nexperia's real ordering-code notation (confirmed against the symbol's
    own datasheet link), not a typo. Verified zero boards reference this
    symbol (grepped cc15/BTT/Sparky/SAO-NFC-M24SR/BSidesKC_2027/Telepresence),
    so this is a zero-impact rename, safe to commit directly per policy.
2026-10-06 docs: document Proto_TFT footprint as exempted/unidentified (Nexus 7514f363)
2026-10-06 rename(symbols): C_.1uf_0805 -> C_0.1uF_0805 (NEEDS KEVIN REVIEW) (#12)
    Value field was already fixed to "0.1uF" in a prior pass, but the
    lib_id itself still had the old lowercase/dotless "C_.1uf_0805" --
    violates the KLC value-formatting convention (leading-zero decimal,
    matches the sibling R_10k_1206/C_1uF_0805 pattern) documented in
    bp-core-parts-standard.md.
    This lib_id IS referenced by cc15 and Project-BlueTeamTool (8 lib_id
    placements across 8 schematic sheets total). Each board caches its own
    copy of the symbol, so nothing breaks today -- but once this merges,
    each board's lib_id + cached copy needs to be re-pointed to the new
    name (see companion branches on cc15/Project-BlueTeamTool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
2026-10-06 fix(display-ili9341): remove phantom board-mount holes/courtyard from module footprint
    Kevin's decision d0137 (Nexus 9ef3094d, 2026-10-06): the ILI9341 module
    does not mount flush on CC15 -- it is its own board, connected only
    through J3's header pins. The footprint's 4 NPTH mounting pads and its
    full 90.5x55.25mm CrtYd rect were still real board-level geometry,
    so DRC correctly flagged them as colliding with Fid-1/Fid-4/Fid-5,
    REF** holes, J7, and SW2 (15 violations, matches Nivek's 9ef3094d
    finding).
    Those holes are the *module's own board's* mounting holes, not CC15
    drills -- nothing is actually bolted through CC15 at those points.
    Converted them from np_thru_hole pads to non-drilled F.F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
2026-10-06 fix(sao): point Badgelife_sao_connector_v169bis sourcing at Sullins SBH11-NBPC-D03-ST-BK
    Kevin's decision d0144 (2026-10-06, recorded by Jared) names the concrete
    SAO standard part as Sullins SBH11-NBPC-D03-ST-BK (LCSC C17480644), a THT
    2x3 2.54mm shrouded+keyed box header implementing the shrouded rule from
    d0139. Mechanically identical pad pattern to the Molex 0878340619 this
    symbol previously cited (both are standard 2.54mm shrouded box headers),
    so only MFG/MFG_PN/LCSC/Datasheet fields change -- no lib_id, footprint,
    or pin change. Molex kept as the documented alternate. Added a missing
    Description field while touching this symbol (canonical field set per
    bp-core-parts-standard.md). Zero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
2026-10-06 docs(9ef3094d): record Keystone-53 and screen-module research + Kevin asks
    Battery: DigiKey parametric data confirms Keystone 53 is ONE part per cell
    (not a pair), AA pitch 52.10mm matches 14500. Existing battery STEP in the
    library is a synthetic approximation, not the real manufacturer export --
    keyelco.com/digikey.com block automated fetch from this box.
    Screen: confirmed AliExpress 3.2in "B" ILI9341+FT6336U module (no SD); no
    public datasheet exists for the harvested listing's mechanical dims --
    needs a calipers pass on the physical module.
    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
2026-10-06 fix(sao): swap bare pin-header 3D model for real shrouded IDC box-header model
    Footprint was still pointing at PinHeader_2x03_P2.54mm_Vertical.step (bare,
    unshrouded) even after the symbol's sourcing was pointed at Sullins
    SBH11-NBPC-D03-ST-BK (2x3, 2.54mm, THT, locking/shrouded, per d0139/d0144).
    Swapped to IDC-Header_2x03_P2.54mm_Vertical.step, the standard KiCad shrouded
    box-header model from the same 2x03_P2.54mm_Vertical pad-origin convention
    (pad 1 at model origin in both families), so offset/rotation carry over
    unchanged. Zero boards place this footprint yet, so no re-point needed.
    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
2026-10-07 fix(battery): replace Keystone-53 procedural stand-in with real LCSC/EasyEDA STEP
    Battery_14500_Keystone53_clips.step was a synthetic Open CASCADE solid,
    not a manufacturer export (flagged in docs/kevin-ask_9ef3094d). Pulled the
    real part via easyeda2kicad --lcsc_id=C5352788 (LCSC listing for Keystone
    53), confirmed it is a single-cell spring+tab contact (not a dual-pad part
    spanning the AA cell), and placed two instances in "Battery - 14500" at the
    existing pad locations, mirrored for polarity. Verified render shows a
    correct blade-spring pose seated on the board at both ends (Nexus 9ef3094d).
    Known gap: copper pad pitch/size on the existing footprint (13.175mm, 4.5x5.5
    + 5.5x3.5) is a clo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
2026-10-07 docs(9ef3094d): mark battery-holder ask resolved, only screen calipers remain
    Item 1 (Keystone-53 real STEP) shipped via easyeda2kicad (66e0904) without
    needing the DigiKey login this doc originally asked for. Flag it so nobody
    re-chases a download that's no longer needed; item 2 (screen module
    calipers) is still the only open physical ask.
2026-10-27 fix(battery-14500): add F.CrtYd courtyard, clear silk-over-pad overlap
    Library footprint had zero courtyard geometry, so the courtyard-overlap
    DRC check never ran against the fleet's physically largest part (pads
    to x=+/-31.05mm). Added a +/-31.3 x +/-7.75mm F.CrtYd rect. Also pulled
    the silk body rect in from +/-27.5mm to +/-25.3mm so its vertical edges
    stop crossing the outer pads (25.55-31.05mm), clearing the fab-clip
    warning on the footprint checker.
    Nexus 0e254999-c945-445a-996f-95863623d58f
2026-11-04 fix(footprint): USB_C_Receptical-Jing attr should be through_hole
    Footprint has real plated thru-hole pads (S1 x4 shield/mounting legs)
    alongside SMD signal pads. attr smd was wrong and triggers a DRC
    footprint_type_mismatch on every board using this part (found on
    cc15 mainboard J4, Nexus 940aa346).
2026-11-06 fix(lib): correct R_330k_1206 identity contradiction, rename to R_330_1206
    Nexus 6a47fd23: symbol Value "330" contradicted its own name/MFG_PN/LCSC
    (YAGEO 330kΩ, C229929, 0 stock). Both known board uses are LED current
    limiters wanting 330Ω (precedent: cc15 R8, Nexus b6a8310f, commit 1fe42d6),
    so corrected the symbol's identity to match instead of re-sourcing a 330kΩ
    part nobody actually wants. Renamed to R_330_1206, re-sourced to UNI-ROYAL
    1206W4F3300T5E / LCSC C17930 (330Ω 1%, verified in stock 2026-11-04).
2026-11-09 fix(footprint): Keystone-53 battery clips were flipped to the back and lying flat in 3D view
    Library default had z offset -1.8mm (pushes the model 1.8mm below a
    1.6mm board, out the back) and a 90 deg X-rotation that laid the clip
    spring body flat instead of standing it up on its mounting ears.
    Verified with kicad-cli pcb render on an isolated test board
    (/tmp scratch, not GAMINGCRAP): before shows clips on the back face
    lying down, after shows both clips upright on F.Cu with ears on pads.
    Pads/layers untouched -- 3D model placement only.
    Nexus dc246852-f713-4e89-af7e-849f4f6745fa
2026-11-09 fix(footprint): ILI9341 screen 3D model had no rotation, body hung off board edge
    Model origin sits near the display's geometric center while the header
    pads sit at one edge (pad 1 at local x=-43.29, body spans local x
    -44.89..45.1). With the footprint's typical 180deg in-plane board
    placement, the display body landed on the wrong side of the connector --
    confirmed on CC15's board (Nexus dc246852) where the body stuck out
    ~80mm past the board edge in free space instead of standing off above
    the board. A model-level rotate Y=180 flips which side the body falls
    on without touching the pads.
2026-11-09 fix(footprint): ILI9341 screen 3D model needed translation, not rotation
    The previous fix (f82870e) added rotate y=180, but the body's local
    bbox (-44.89..45.11, -29.02..27.54) is nearly symmetric about the
    origin, so rotating about an axis through the origin barely moved it
    -- Carla's independent re-render caught that the body was still
    hanging off the board edge at essentially the same position.
    Root cause: the footprint's pads land on-board correctly via its
    stored 180deg placement rotation, but that same rotation also flips
    which direction the body extends from the connector -- away from the
    board instead of over it. A rotation centered at the local origin
    can't fix that when the origin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
